BLA22003057/LinearMechanism/README.md

# Linear Mechanism (Project 1)
Files for a linear mechanism that will lift 30g by 150mm minimum
