BLA22003057/LinearMechanism/models/main - main body.stl

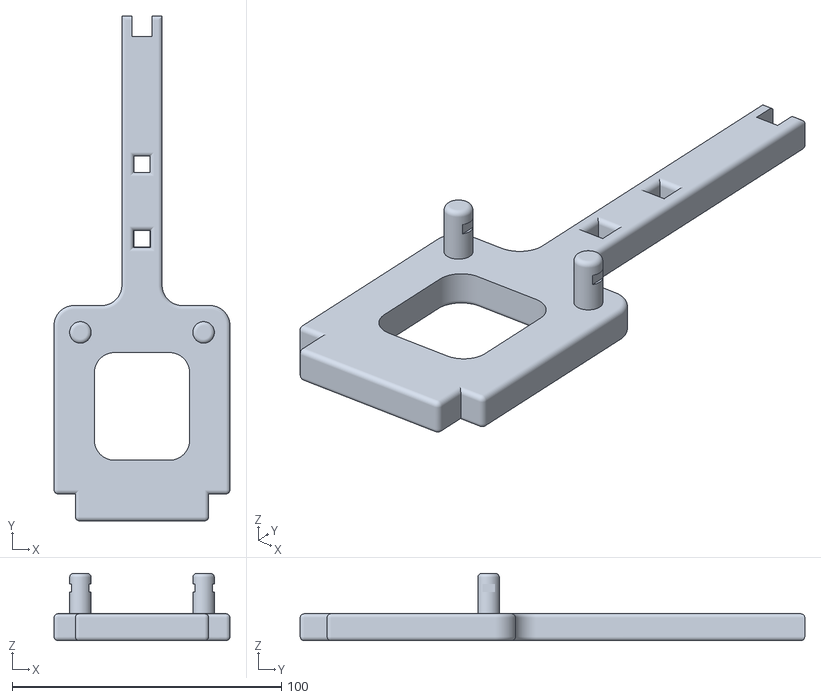
[picture p1: CAD file, 2024-09-17]
models/main - main body.stl
65.4 x 187.5 x 25.0
