BLA22003057/LinearMechanism/models/main - gear shaft ring.stl

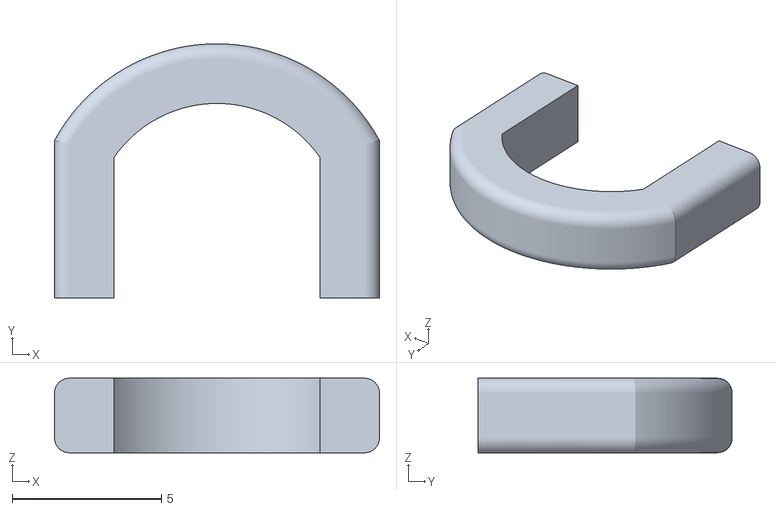
[picture p2: CAD file, 2024-09-17]
models/main - gear shaft ring.stl
10.9 x 8.53 x 2.50
