BLA22003057/LinearMechanism/models/main - midpoint string guide.stl

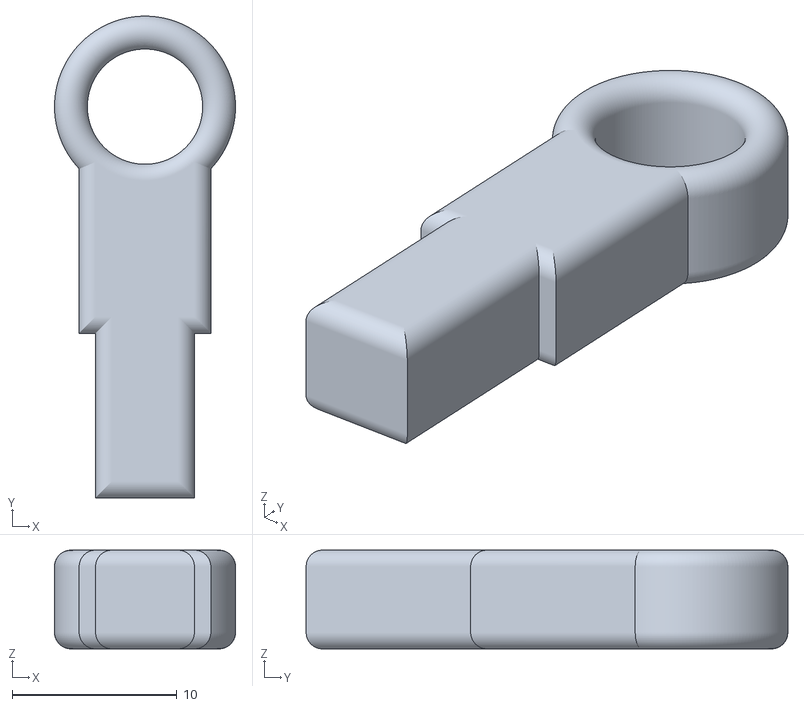
[picture p3: CAD file, 2024-09-17]
models/main - midpoint string guide.stl
11.0 x 29.3 x 6.00
