BLA22003057/LinearMechanism/models/main - gear test mount.stl

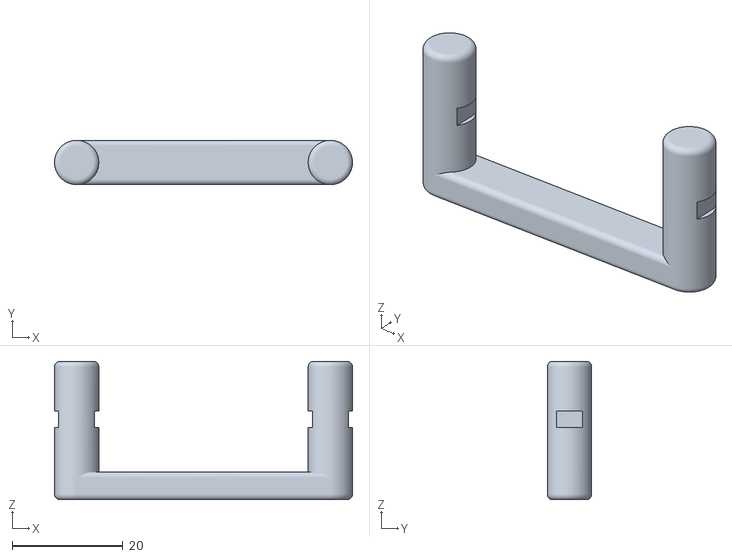
[picture p4: CAD file, 2024-09-17]
models/main - gear test mount.stl
53.8 x 8.00 x 25.0
