BLA22003057/LinearMechanism/models/main - Spur gear (24 teeth).stl

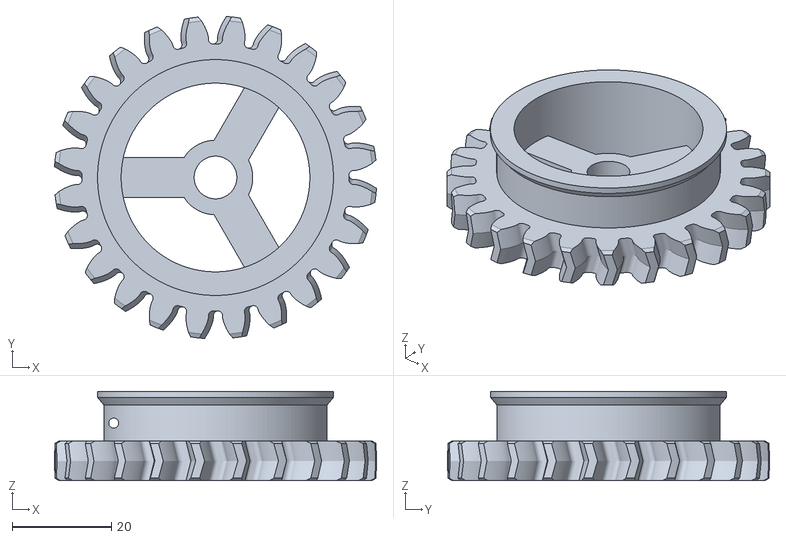
[picture p5: CAD file, 2024-09-17]
models/main - Spur gear (24 teeth).stl
64.9 x 64.9 x 18.0
