BLA22003057/LinearMechanism/models/main - Spur gear (12 teeth).stl

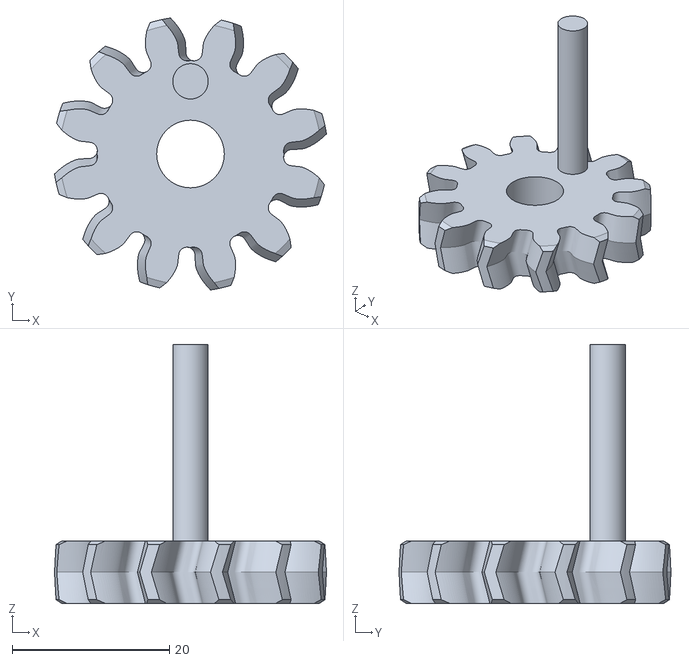
[picture p6: CAD file, 2024-09-17]
models/main - Spur gear (12 teeth).stl
34.6 x 34.6 x 33.0
