BLA22003057/LinearMechanism/design/drawings/Assembly.pdf

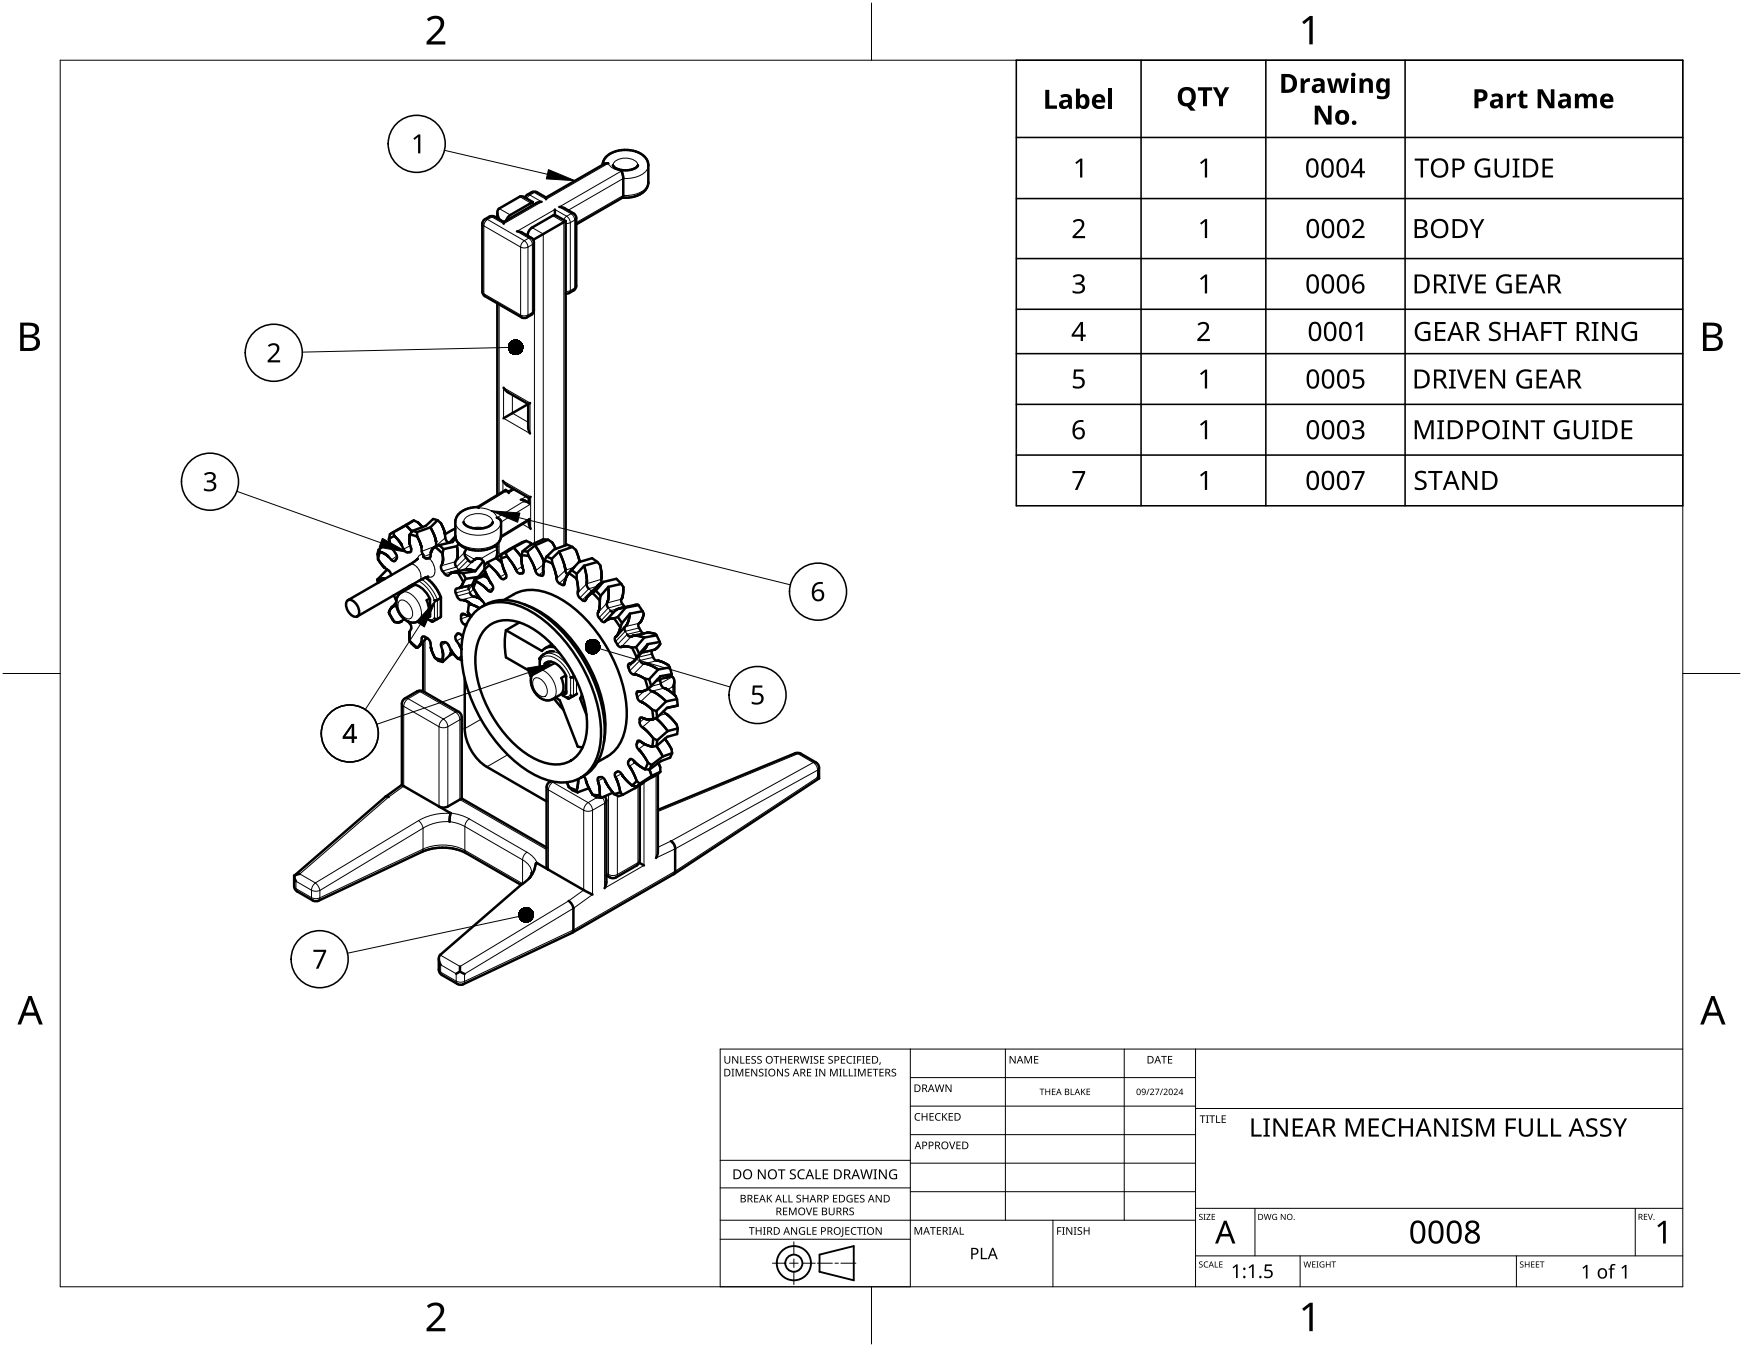
[picture p7: page 1]
